yongjun21/Maker-Projects/Impeller-Project/Machining.jpg

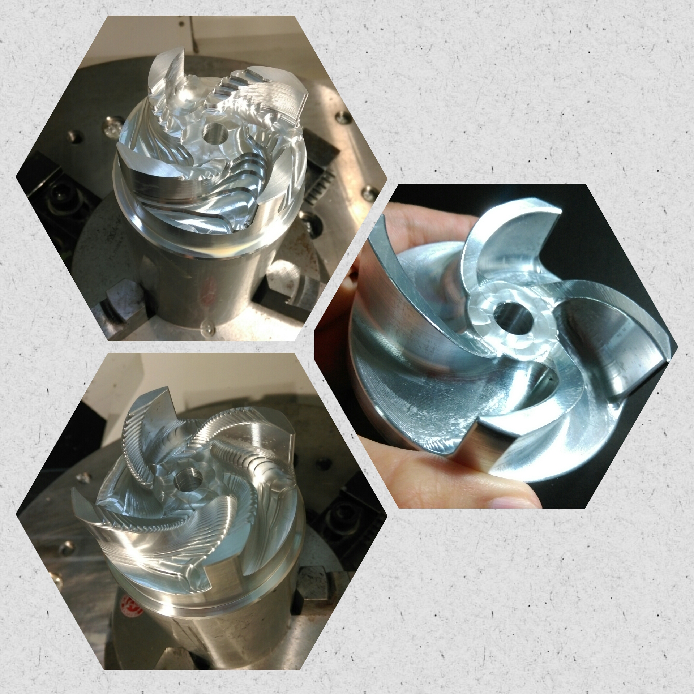
Impeller-Project/Machining.jpg
