yongjun21/Maker-Projects/Impeller-Project/Photos/IMAG0180.jpg

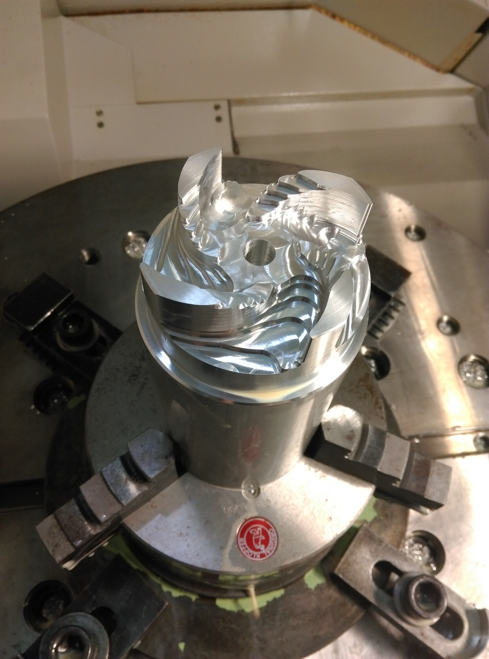
Impeller-Project/Photos/IMAG0180.jpg
