yongjun21/Maker-Projects/Impeller-Project/Photos/IMAG0181.jpg

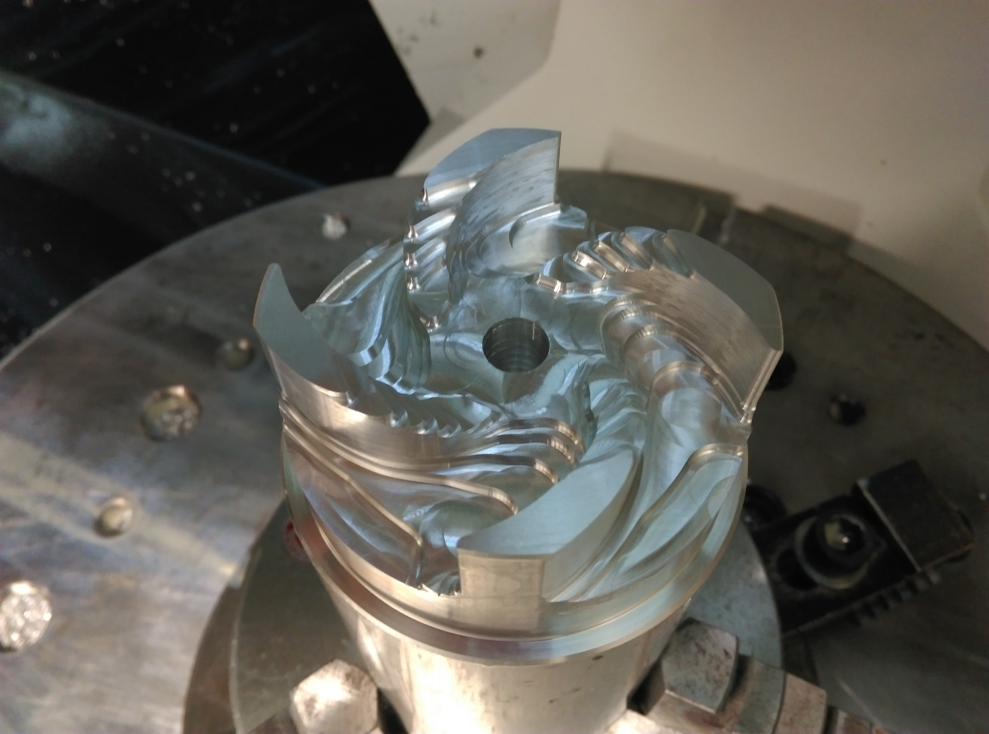
Impeller-Project/Photos/IMAG0181.jpg
