yongjun21/Maker-Projects/Impeller-Project/Photos/IMAG0182.jpg

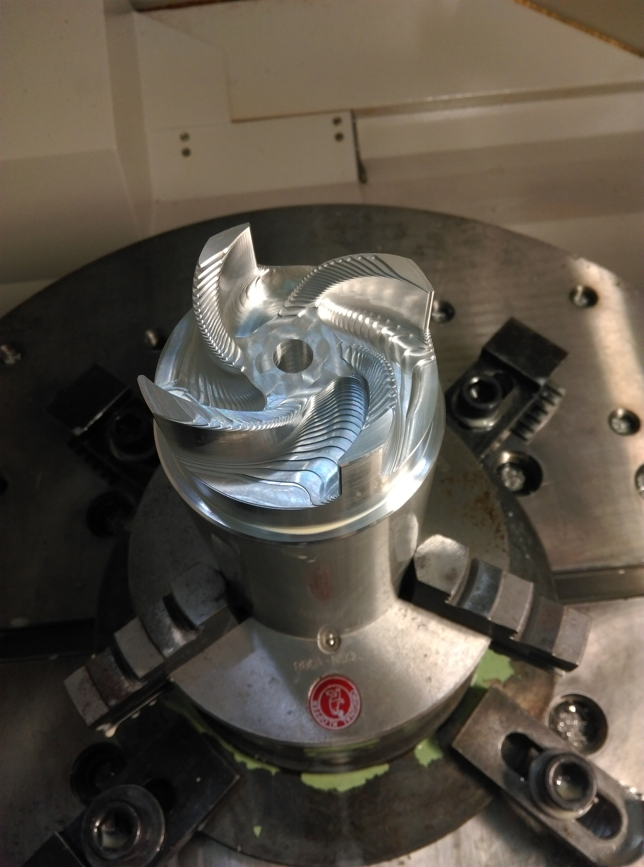
Impeller-Project/Photos/IMAG0182.jpg
