yongjun21/Maker-Projects/Impeller-Project/Photos/IMAG0183.jpg

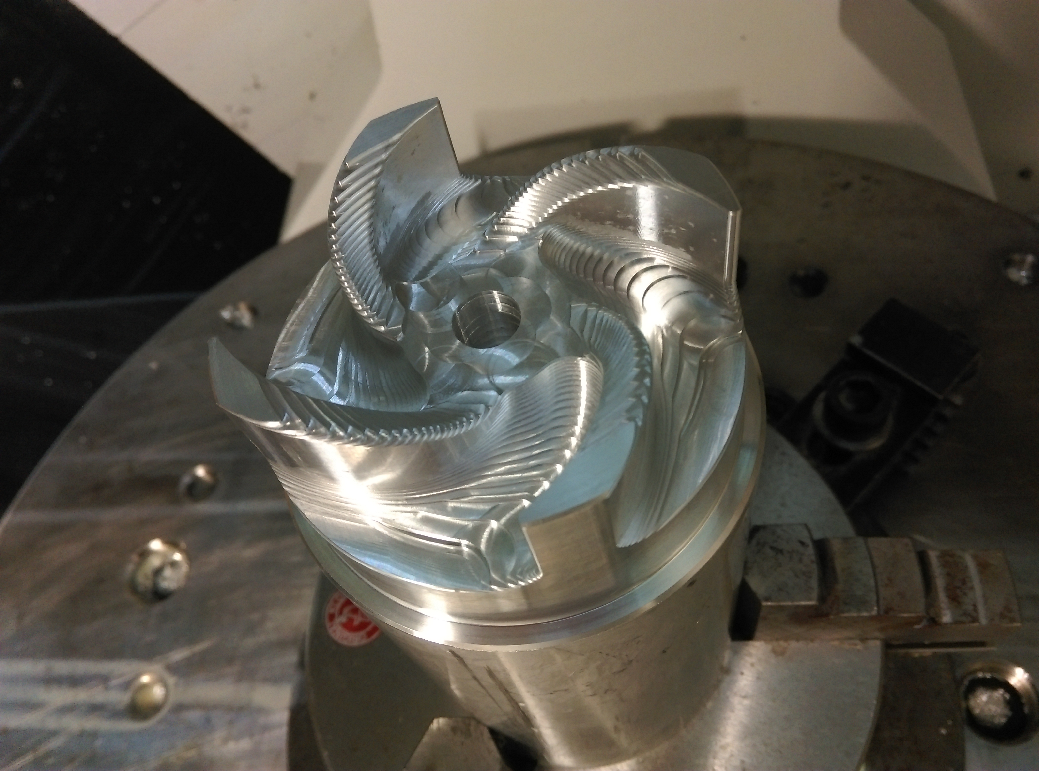
Impeller-Project/Photos/IMAG0183.jpg
