yongjun21/Maker-Projects/Impeller-Project/Impeller_DWG.pdf

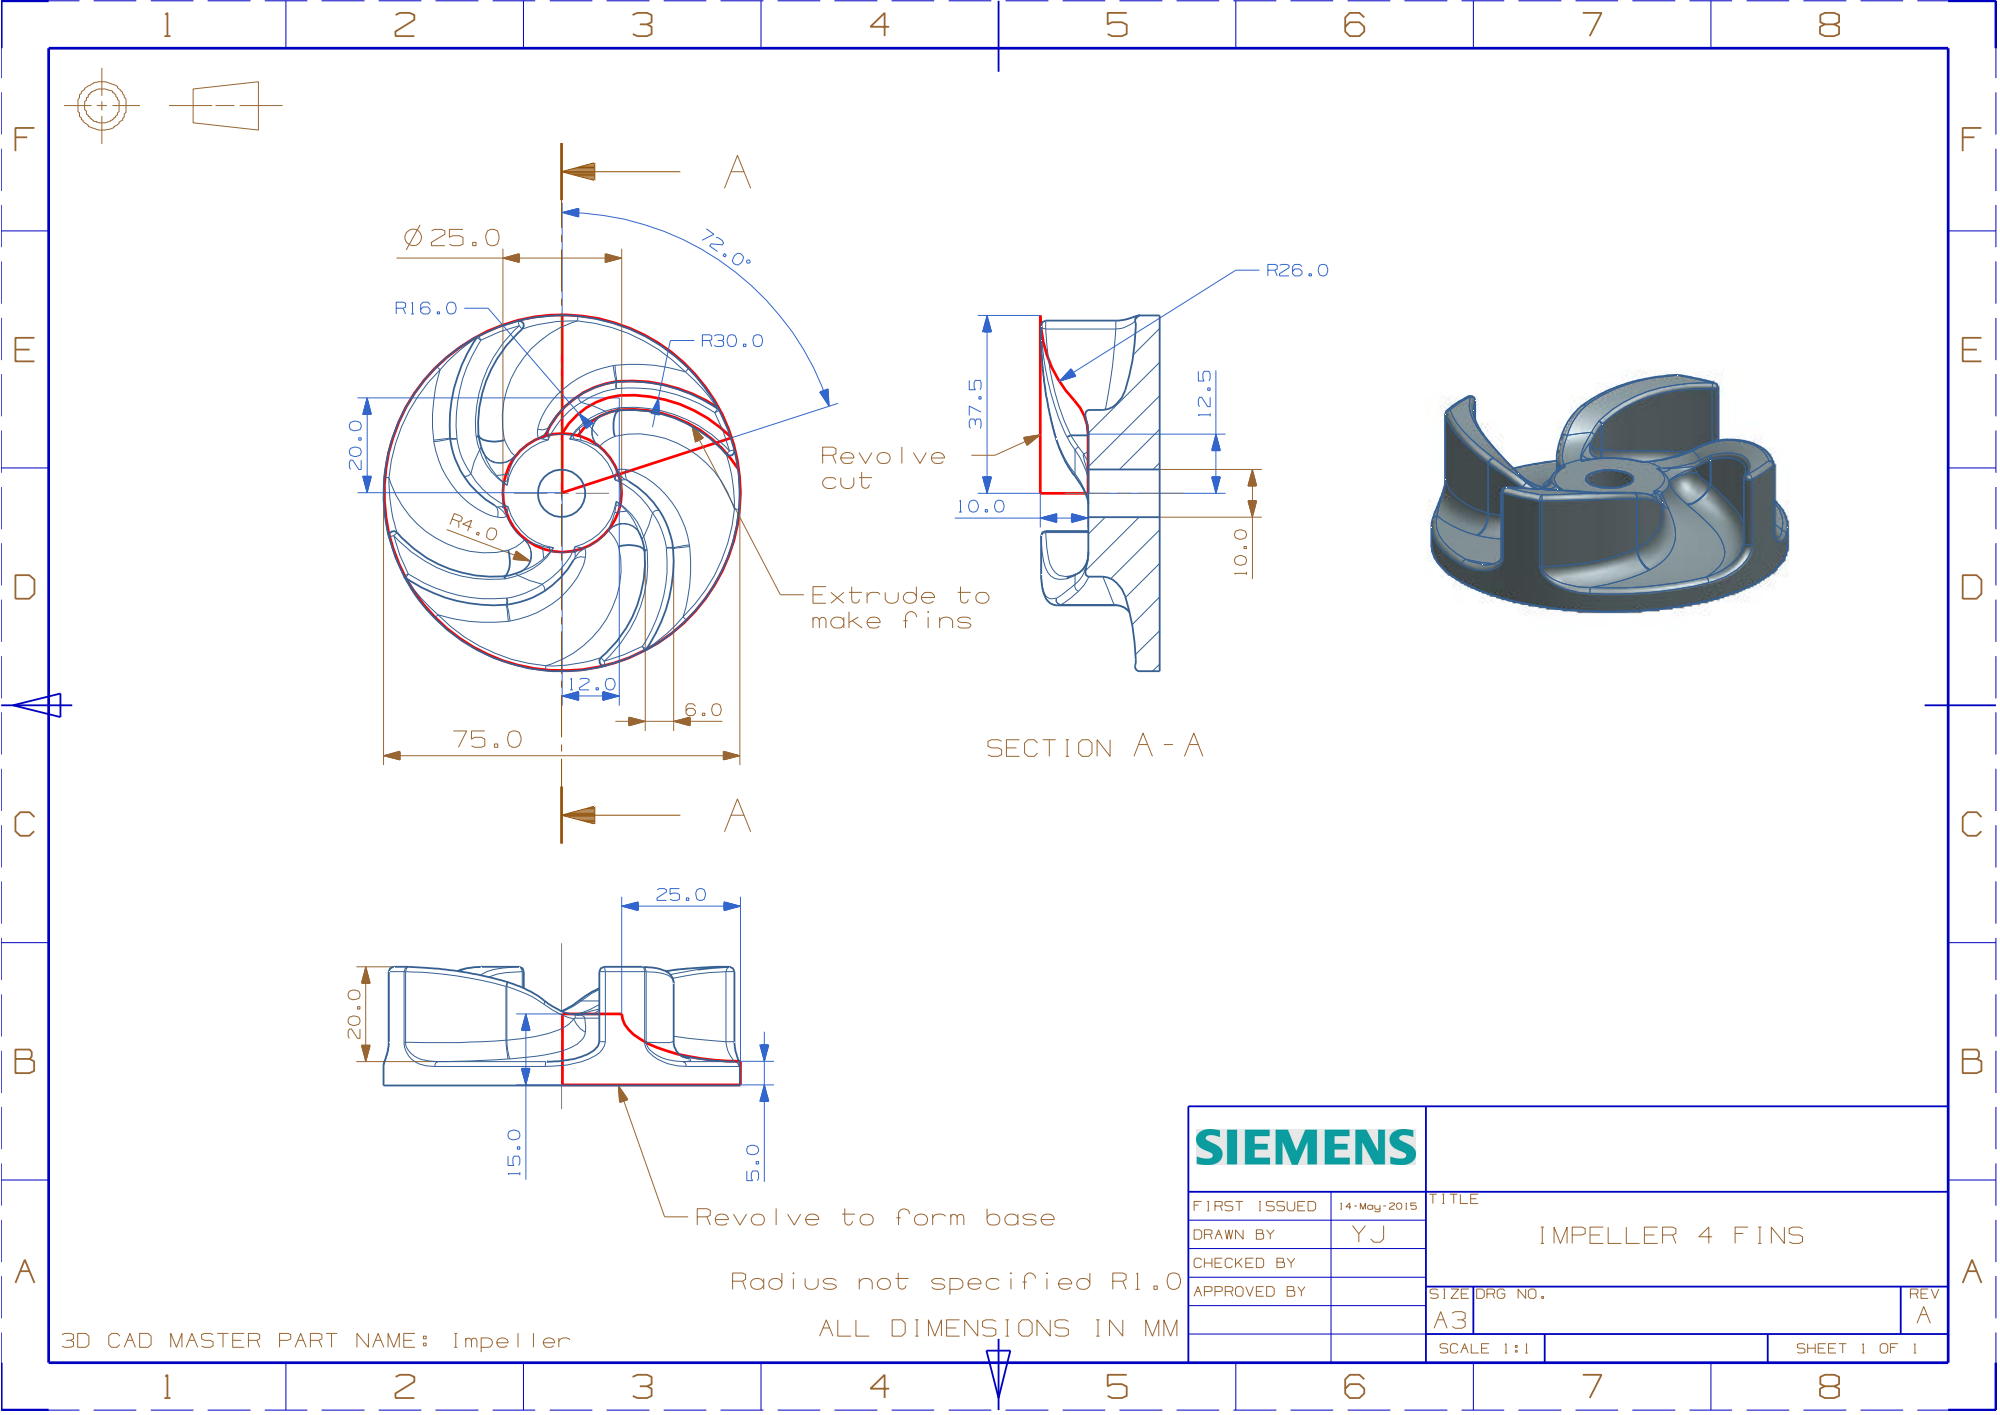
[picture p7: page 1]
