yongjun21/Maker-Projects/(list of files, cad)

Other CAD files:
Impeller-Project/CAD CAM files/Impeller.prt
Impeller-Project/CAD CAM files/Impeller_BLANK.prt
Impeller-Project/CAD CAM files/Impeller_BLANK_setup_1.prt
Impeller-Project/CAD CAM files/Impeller_CAM.prt
Impeller-Project/CAD CAM files/Impeller_dwg1.prt
